Blario123/CountdownDisplay/Hardware/Circuit/Circuit.kicad_pcb

## KiCad design Hardware/Circuit/Circuit.kicad_pcb (2024-10-17)

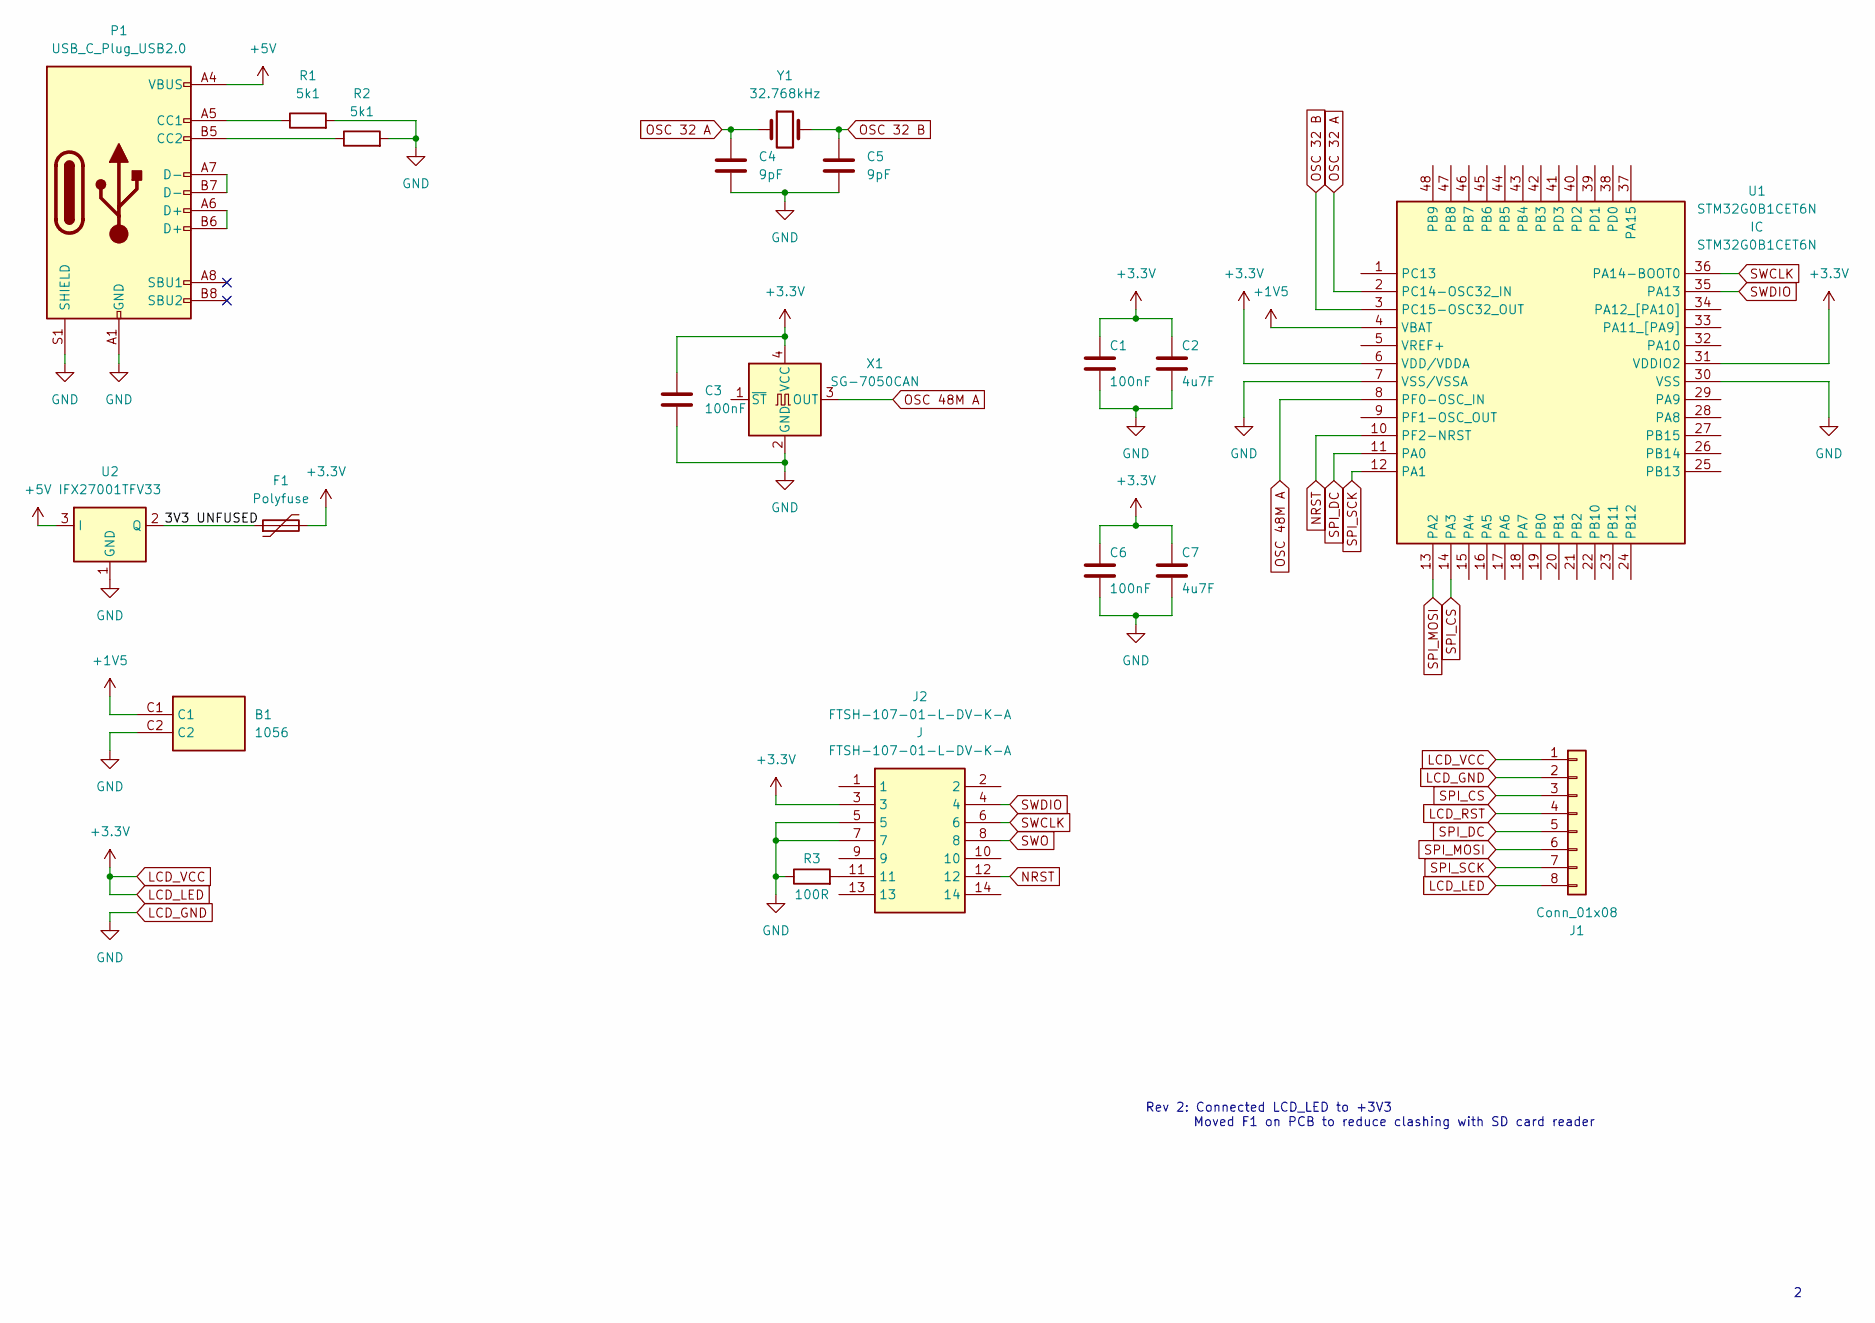
[picture p1: schematic Circuit.kicad_sch]

Parts:
B1: 1056; Manufacturer_Part_Number 1056; Mouser Part Number 534-1056
C1, C3, C6: 100nF; C_0805_2012Metric
C2, C7: 4u7F; C_0805_2012Metric
C4, C5: 9pF; C_0805_2012Metric
F1: Polyfuse; Fuse_Bourns_MF-RG300
J1: Conn_01x08; PinSocket_1x08_P2.54mm_Vertical
J2: FTSH-107-01-L-DV-K-A; FTSH-107-XX-YYY-DV-K-A; Manufacturer_Part_Number FTSH-107-01-L-DV-K-A; Mouser Part Number 200-FTSH10701LDVKA
P1: USB_C_Plug_USB2.0; USB_C_Receptacle_GCT_USB4085
R1, R2: 5k1; R_0805_2012Metric
R3: 100R; R_0805_2012Metric
U1: STM32G0B1CET6N; LQFP-48_7x7mm_P0.5mm; Manufacturer_Part_Number STM32G0B1CET6N; Mouser Part Number 511-STM32G0B1CET6N
U2: IFX27001TFV33; TO-252-3_TabPin2
X1: SG-7050CAN; Oscillator_SMD_SeikoEpson_SG8002CA-4Pin_7.0x5.0mm
Y1: 32.768kHz; Crystal_SMD_3215-2Pin_3.2x1.5mm

Connections:
+1V5: B1.C1, U1.4 (VBAT)
+5V: P1.A4 (VBUS), P1.A9 (VBUS), P1.B4 (VBUS), P1.B9 (VBUS), U2.3 (I)
/3V3 UNFUSED: F1.1, U2.2 (Q)
LCD_GND: B1.C2, C1.2, C2.2, C3.2, C4.2, C5.2, C6.2, C7.2, J1.2, J2.5, J2.7, P1.A1 (GND), P1.A12 (GND), P1.B1 (GND), P1.B12 (GND), P1.S1 (SHIELD), R1.2, R2.2, R3.1, U1.7 (VSS/VSSA), U1.30 (VSS), U2.1 (GND), X1.2 (GND)
LCD_LED: C1.1, C2.1, C3.1, C6.1, C7.1, F1.2, J1.1, J1.8, J2.3, U1.6 (VDD/VDDA), U1.31 (VDDIO2), X1.4 (VCC)
LCD_RST: J1.4
NRST: J2.12, U1.10 (PF2-NRST)
unnamed: J2.11, R3.2
unnamed: P1.A5 (CC1), R1.1
unnamed: P1.A6 (D+), P1.B6 (D+)
unnamed: P1.A7 (D-), P1.B7 (D-)
unnamed: P1.B5 (CC2), R2.1
OSC 32 A: C4.1, U1.2 (PC14-OSC32_IN), Y1.1
OSC 32 B: C5.1, U1.3 (PC15-OSC32_OUT), Y1.2
OSC 48M A: U1.8 (PF0-OSC_IN), X1.3 (OUT)
SPI_CS: J1.3, U1.14 (PA3)
SPI_DC: J1.5, U1.11 (PA0)
SPI_MOSI: J1.6, U1.13 (PA2)
SPI_SCK: J1.7, U1.12 (PA1)
SWCLK: J2.6, U1.36 (PA14-BOOT0)
SWDIO: J2.4, U1.35 (PA13)
SWO: J2.8

Notes on the sheet:
Rev 2: Connected LCD_LED to +3V3 Moved F1 on PCB to reduce clashing with SD card reader

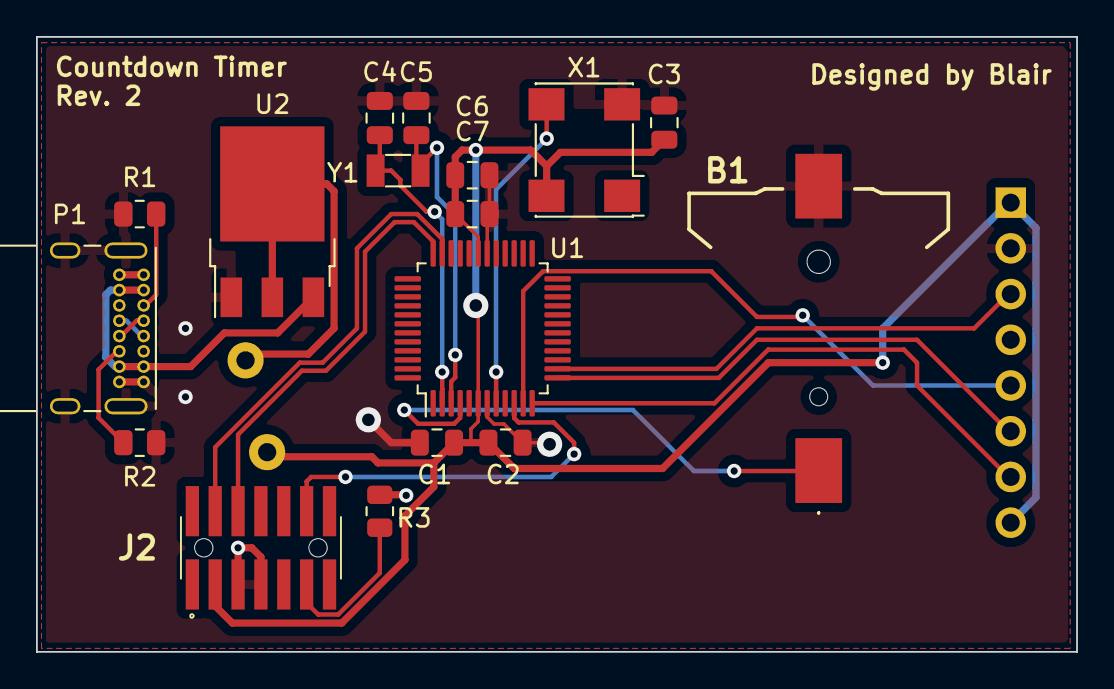
[picture p2: board Circuit.kicad_pcb from above]

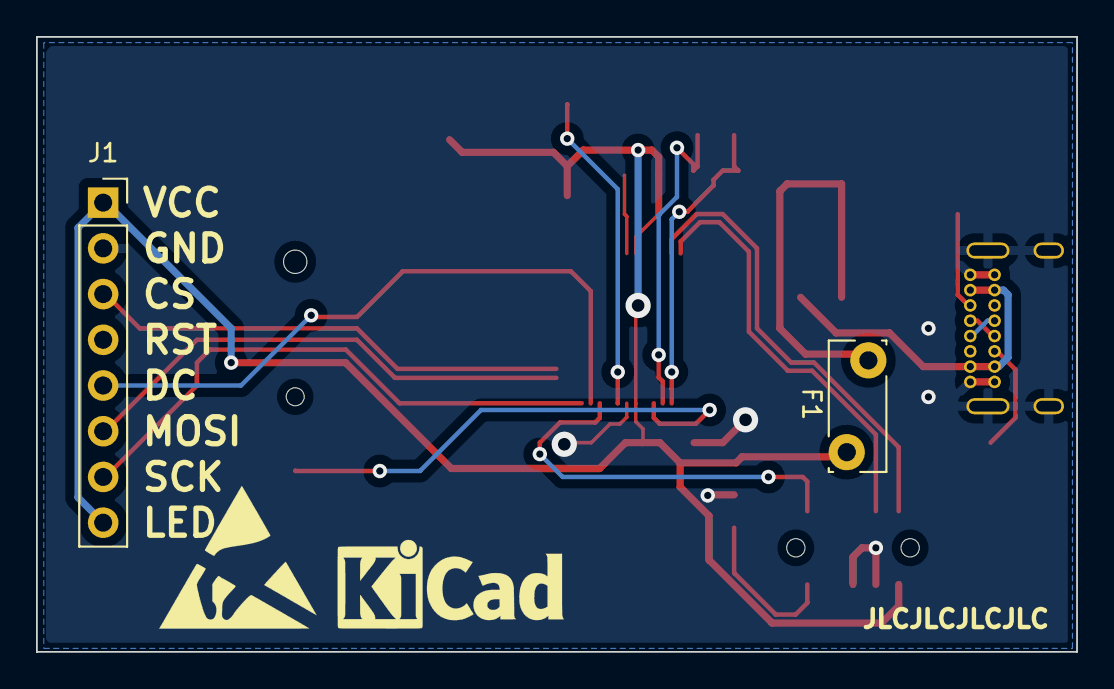
[picture p3: board Circuit.kicad_pcb from below]

Board: 2 copper layers, 57.8 x 34.2 mm, 19 parts (2 on the bottom side), 20 nets.
