Blario123/CountdownDisplay/Software/CountdownDisplayActual/CountdownDisplayActual.ioc

Mcu.UserName=STM32G0B1CETxN
PA0.GPIO_Label=SPI_DC
PA0.Signal=GPIO_Output
PA1.Signal=SPI1_SCK
PA13.Signal=SYS_SWDIO
PA14-BOOT0.Signal=SYS_SWCLK
PA2.Signal=SPI1_MOSI
PA3.GPIO_Label=SPI_CS
PA3.Signal=GPIO_Output
PA6.Signal=SPI1_MISO
