Blario123/CountdownDisplay/(commit log)

2024-10-17 Initial Commit
    Software: Not finished
    Hardware: Rev 2
    [Circuit-B_Cu.gbr, Circuit-B_Mask.gbr, Circuit-B_Paste.gbr, Circuit-B_Silkscreen.gbr, Circuit-Edge_Cuts.gbr, Circuit-F_Cu.gbr, Circuit-F_Mask.gbr, Circuit-F_Paste.gbr]
2024-10-29 Tinkering with clock sources
    It is suspected that the clock source is not working, thus the SPI will not control the display.
    Also removed the debug/release build directories generated by STM32CubeIDE
    [CountdownDisplayActual.ioc, main.c]
2024-10-30 Semi-working text rendering
    Weird behaviour of the board, but occasionally the text will properly render. Possible electrical issue.
    [CountdownDisplayActual.ioc, main.c, main.h]
2024-10-31 Missing HAL_SPI_Abort()
    The reason behind the display not updating was due to the fact that the SPI bus had not been aborted after a transmission and moving onto the next.
    Also adding in date/time calculations
    [CountdownDisplayActual.ioc, main.c, main.h]
